pinae/Knob-Louder/CAD-Files/Knopf.stl

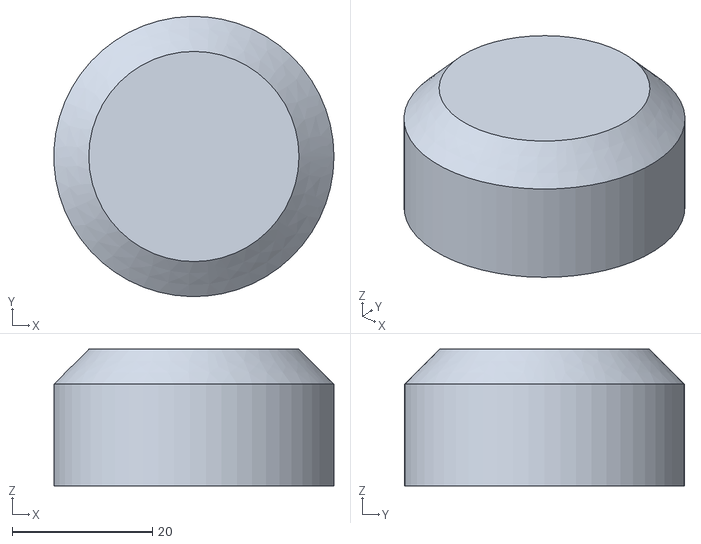
[picture p3: CAD file, 2020-07-20]
CAD-Files/Knopf.stl
40.0 x 40.0 x 19.5
