pinae/Knob-Louder/CAD-Files/Gehäuse.FCStd

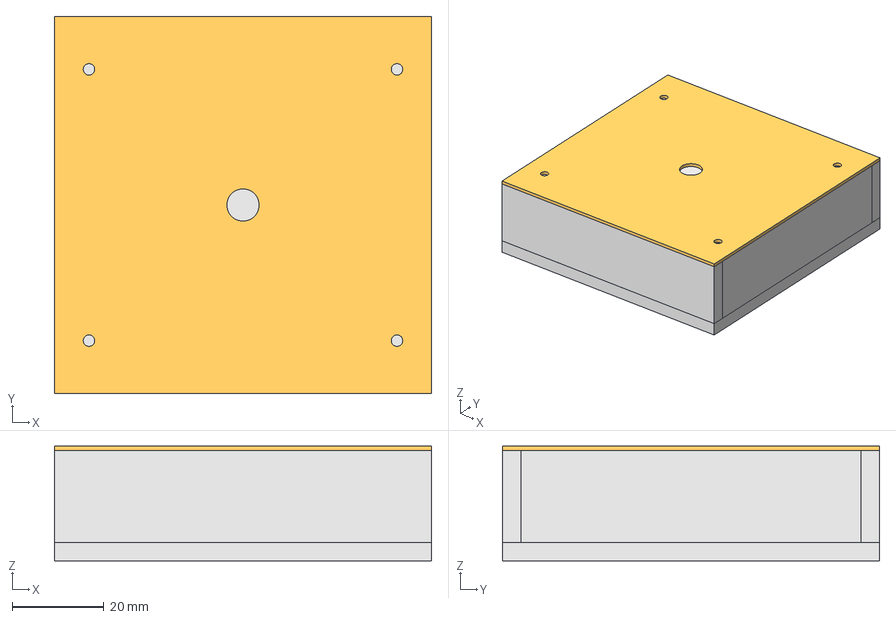
[picture p4: CAD file, 2020-07-20]
CAD-Files/Gehäuse.FCStd
82.0 x 82.0 x 25.0 mm
Deckplatte (Messing)
Seitenwand (Multiplex) rechts
Seitenwand (Multiplex) links
Boden (Sperrholz)
Front (Sperrholz)
Rückwand (Sperrholz)
