pinae/Knob-Louder/(list of files, cad)

Other CAD files:
CAD-Files/Drehknopf.FCStd
