pinae/Knob-Louder/CAD-Files/Case-TechnicalDrawing.pdf

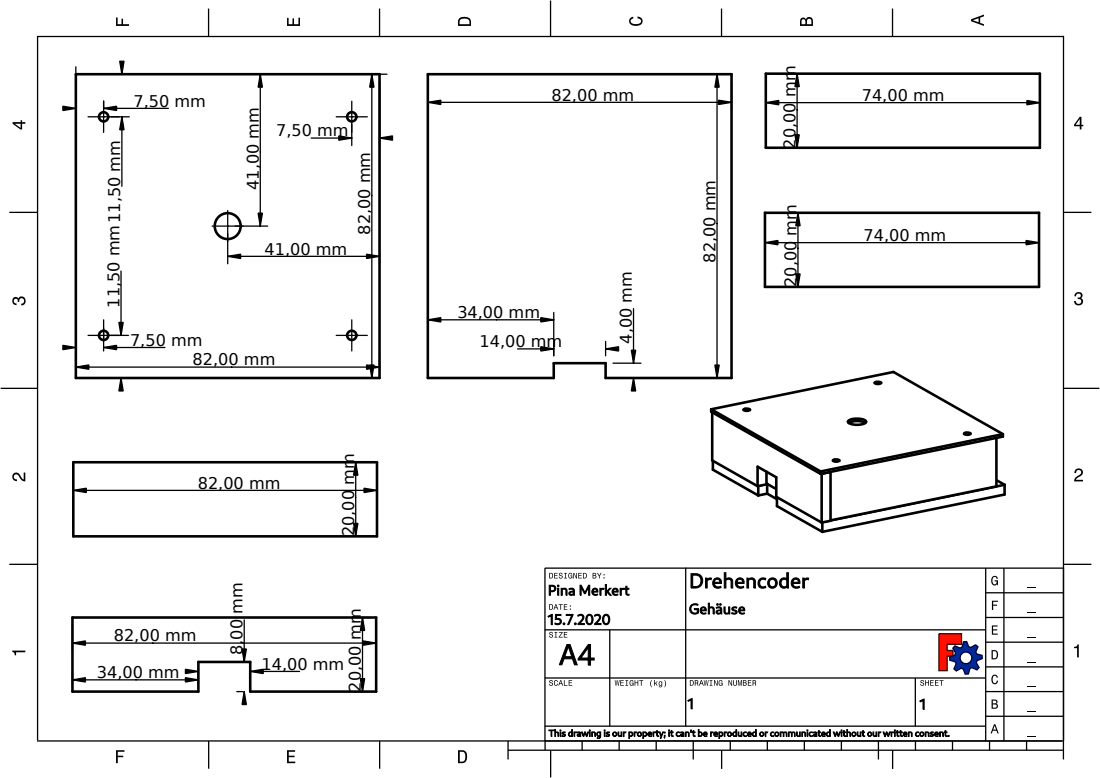
[picture p5: page 1]
