pinae/Knob-Louder/(commit log)

2020-07-20 CAD files and drawings for the case
    [Drehknopf.FCStd, Gehäuse.FCStd, Knopf.stl]
2020-08-05 Information on the wiring
